Supidoc/MPT-PCB/MPT.kicad_pcb

## KiCad design MPT.kicad_pcb (2026-10-22)

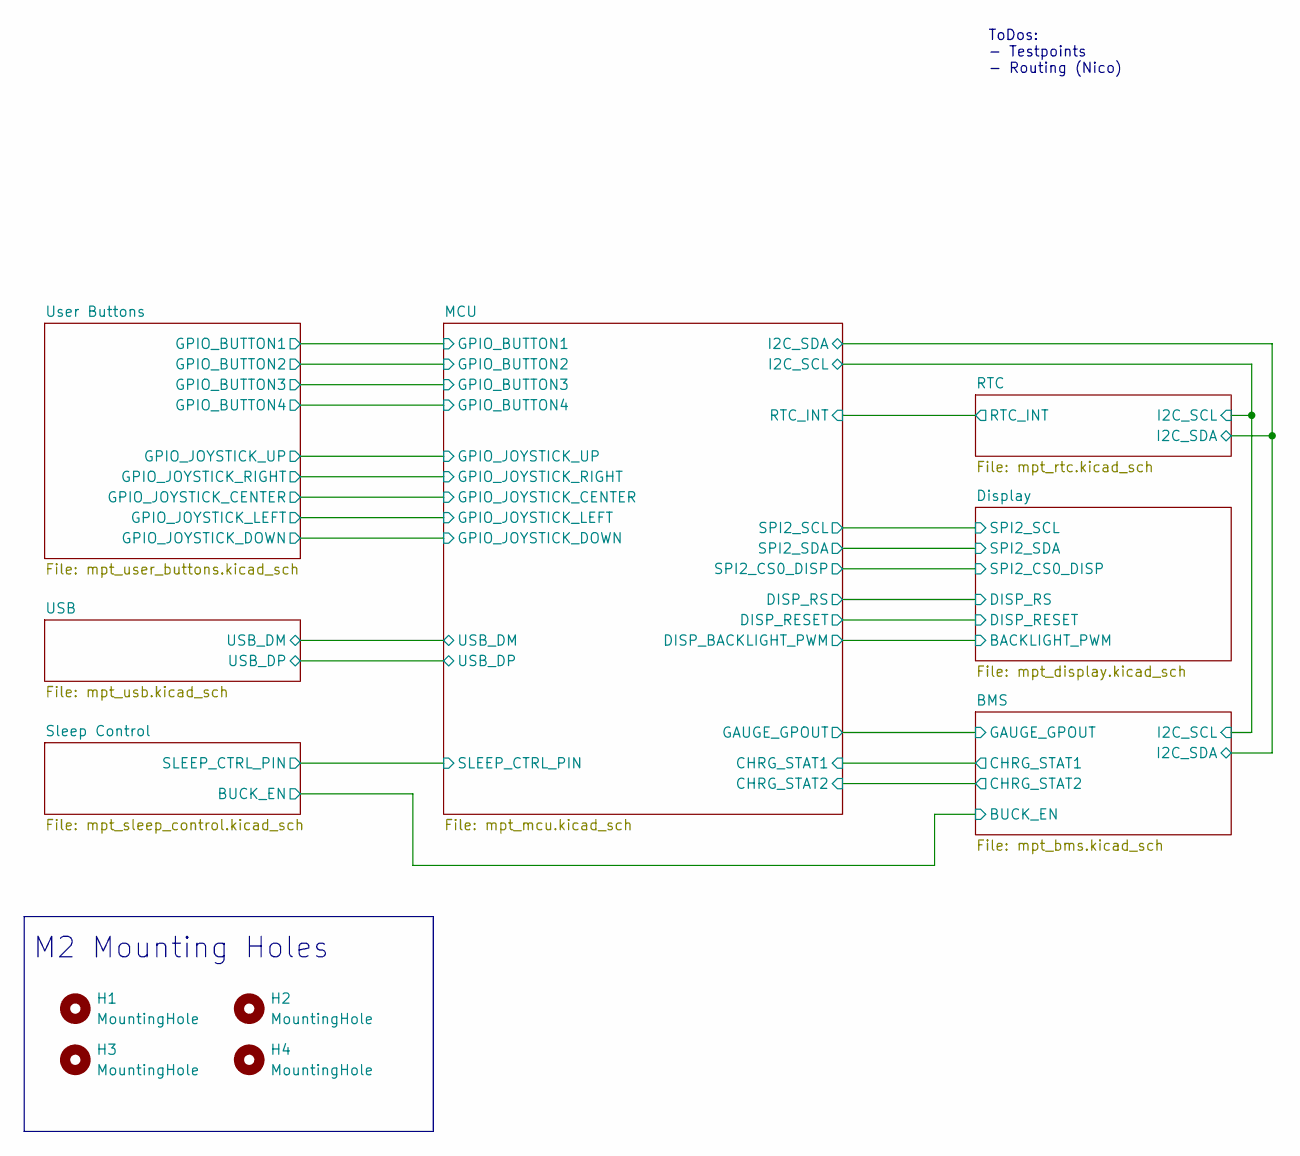
[picture p1: schematic MPT.kicad_sch, MultiPurpose Tracker (M.P.T.)]

Parts:
H1, H2, H3, H4: MountingHole; MountingHole_2.2mm_M2

Notes on the sheet:
ToDos: - Testpoints - Routing (Nico)
M2 Mounting Holes

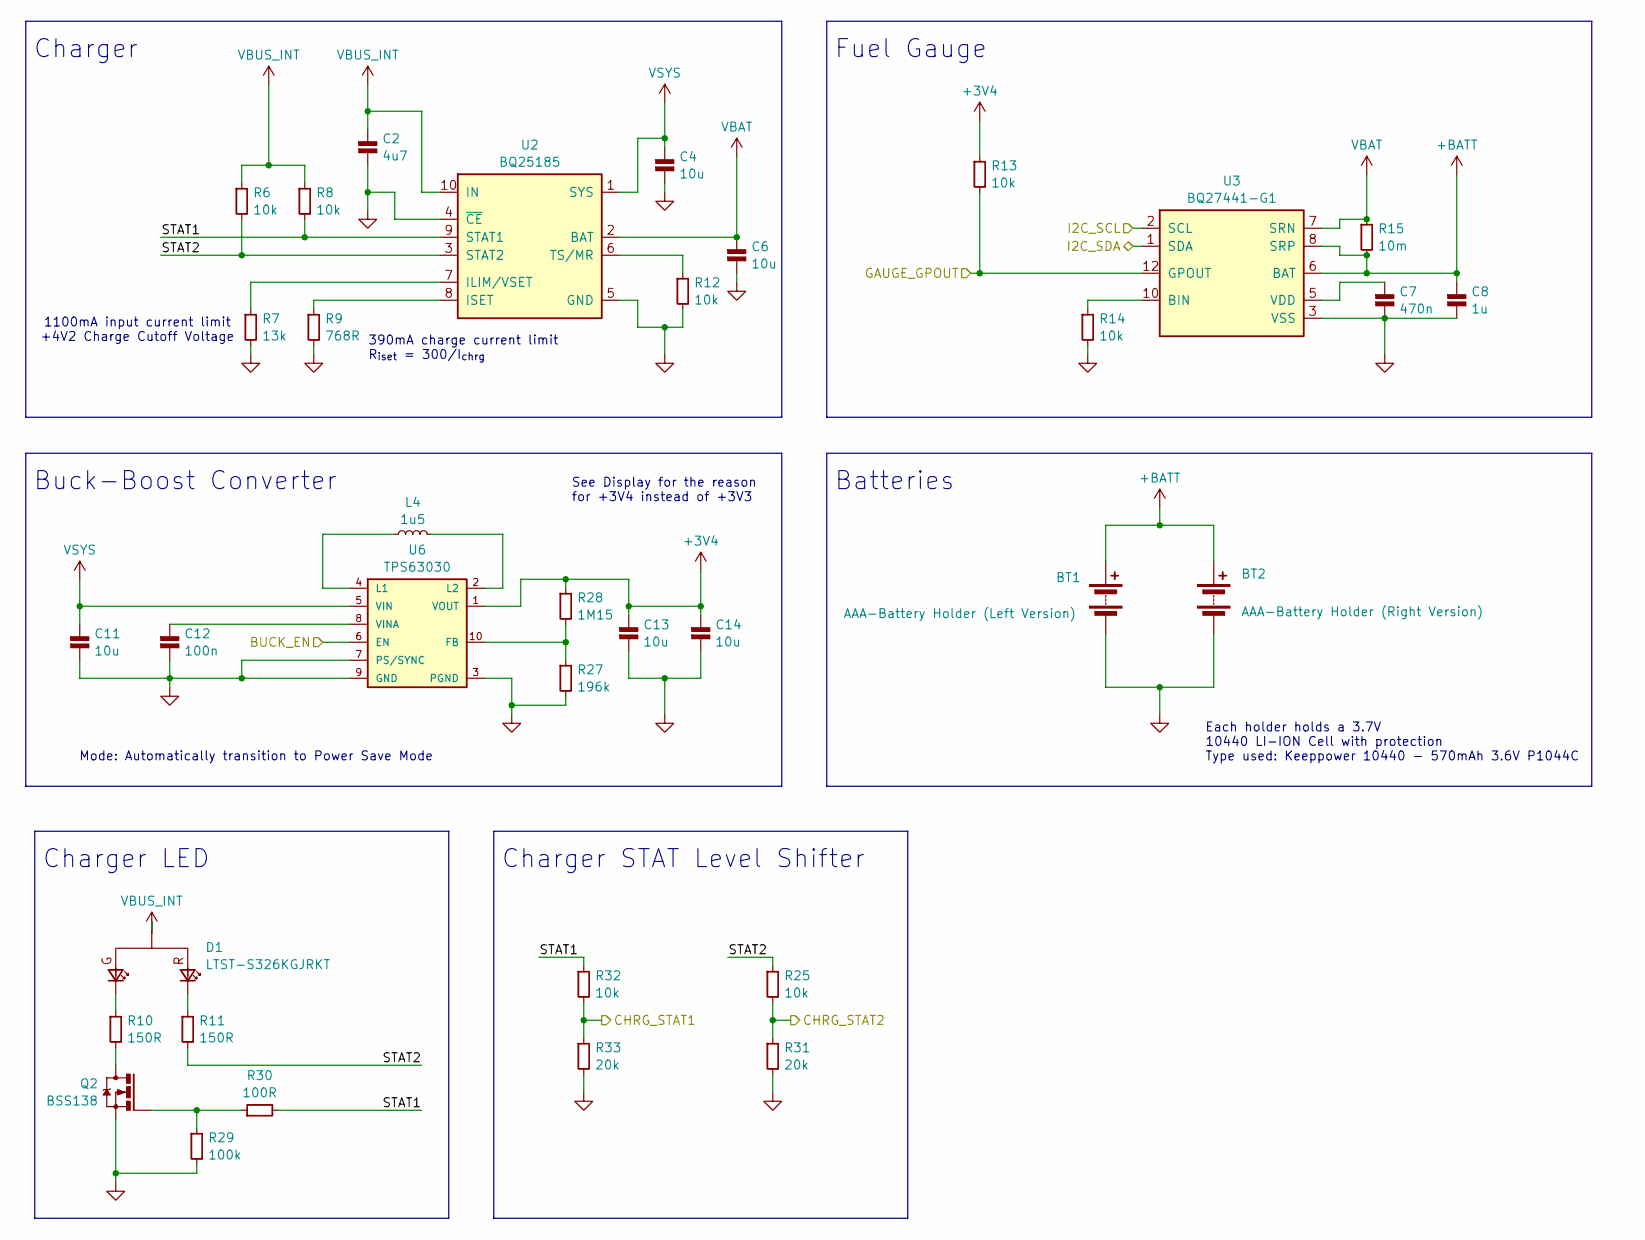
[picture p2: schematic mpt_bms.kicad_sch, M.P.T BMS]

Parts:
BT1: AAA-Battery Holder (Left Version); battery_holder_aaa_right_angle_left; MFR# 2466
BT2: AAA-Battery Holder (Right Version); battery_holder_aaa_right_angle_right; MFR# 2466
C2: 4u7; C_0805; Rating 25V 10%; MFR# CC0805KKX7R8BB475
C4, C6, C11, C13, C14: 10u; C_0603; Rating 10V 20%; MFR# CC0603MRX5R6BB106
C7: 470n; C_0603; Rating 16V 10%; MFR# CC0603KRX7R7BB474
C8: 1u; C_0603; Rating 50V 10%; MFR# CC0603KRX7R9BB105
C12: 100n; C_0603; Rating 25V 10%; MFR# CC0603KRX7R8BB104
D1: LTST-S326KGJRKT; LED_RG_0805_Right_Angle; Rating Red 2Vf, Green 2Vf; MFR# LTST-S326KGJRKT
L4: 1u5; L_2.5mmx1.9mm; Rating 2A6, 20%, 80mOhm; MFR# SRP2010TMA-1R5M
Q2: BSS138; SOT-23; Rating 50 V 220mA; MFR# BSS138
R6, R8, R12, R13, R14, R25, R32: 10k; R_0603; Rating 125mW, 1%; MFR# RC0603FR-0710KL
R7: 13k; R_0603; Rating 125mW, 1%; MFR# RC0603FR-0713KL
R9: 768R; R_0603; Rating 125mW, 1%; MFR# RC0603FR-07768RL
R10, R11: 150R; R_0603; Rating 125mW, 1%; MFR# RC0603FR-07150RL
R15: 10m; R_0603; Rating 0.5W, 1%; MFR# PA0603FRE570R01L
R27: 196k; R_0603; Rating 125mW, 1%; MFR# RC0603FR-07196KL
R28: 1M15; R_0603; Rating 125mW, 1%; MFR# RC0603FR-071M15L
R29: 100k; R_0603; Rating 125mW, 1%; MFR# RC0603FR-07100KL
R30: 100R; R_0603; Rating 125mW, 1%; MFR# RC0603FR-07100RL
R31, R33: 20k; R_0603; Rating 125mW, 1%; MFR# RC0603FR-0720KL
U2: BQ25185; WSON-10-1EP_2.2x2mm_P0.4mm; Rating 1 Cell, 1 A; MFR# BQ25185DLHR
U3: BQ27441-G1; VSON-12-1EP_2.5_4mm_P0.4mm; MFR# BQ27441DRZR-G1A
U6: TPS63030; WSON-10-1EP_2.5x2.5mm_P0.5mm; Rating 1A; MFR# TPS63030DSKR

Connections:
+3V4: C13.1, C14.1, R13.1, R28.1, U6.1 (VOUT); also elsewhere on the board
+BATT: BT1.1 (+), BT2.1 (+), C8.1, R15.2, U3.6 (BAT), U3.8 (SRP)
/BMS/BUCK_EN: U6.6 (EN); also elsewhere on the board
/BMS/CHRG_STAT1: R32.2, R33.1; also elsewhere on the board
/BMS/CHRG_STAT2: R25.2, R31.1; also elsewhere on the board
/BMS/GAUGE_GPOUT: R13.2, U3.12 (GPOUT); also elsewhere on the board
/BMS/I2C_SCL: U3.2 (SCL); also elsewhere on the board
/BMS/I2C_SDA: U3.1 (SDA); also elsewhere on the board
/BMS/STAT1: R8.2, R30.2, R32.1, U2.9 (STAT1)
/BMS/STAT2: R6.2, R11.2, R25.1, U2.3 (STAT2)
GND: BT1.2 (-), BT2.2 (-), C2.2, C4.2, C6.2, C7.2, C8.2, C11.2, C12.2, C13.2, C14.2, Q2.2 (S), R7.2, R9.2, R12.2, R14.2, R27.2, R29.2, R31.2, R33.2, U2.0 (PAD), U2.4 (~CE), U2.5 (GND), U3.0 (PAD), U3.3 (VSS), U6.0 (PAD), U6.3 (PGND), U6.7 (PS/SYNC), U6.9 (GND); also elsewhere on the board
unnamed: D1.3 (C_G), R10.1
unnamed: D1.1 (C_R), R11.1
unnamed: Q2.3 (D), R10.2
unnamed: Q2.1 (G), R29.1, R30.1
unnamed: R7.1, U2.7 (ILIM/VSET)
unnamed: R9.1, U2.8 (ISET)
unnamed: R12.1, U2.6 (TS/MR)
unnamed: R14.1, U3.10 (BIN)
unnamed: C7.1, U3.5 (VDD)
unnamed: R27.1, R28.2, U6.10 (FB)
unnamed: L4.1, U6.4 (L1)
unnamed: L4.2, U6.2 (L2)
unnamed: C12.1, U6.8 (VINA)
VBAT: C6.1, R15.1, U2.2 (BAT), U3.7 (SRN); also elsewhere on the board
VBUS_INT: C2.1, D1.2 (A), R6.1, R8.1, U2.10 (IN); also elsewhere on the board
VSYS: C4.1, C11.1, U2.1 (SYS), U6.5 (VIN); also elsewhere on the board

Notes on the sheet:
Charger
Buck-Boost Converter
390mA charge current limit R_{iset} = 300/I_{chrg}
Fuel Gauge
Batteries
Charger STAT Level Shifter
See Display for the reason for +3V4 instead of +3V3
Each holder holds a 3.7V 10440 LI-ION Cell with protection Type used: Keeppower 10440 - 570mAh 3.6V P1044C
Mode: Automatically transition to Power Save Mode
1100mA input current limit +4V2 Charge Cutoff Voltage
Charger LED

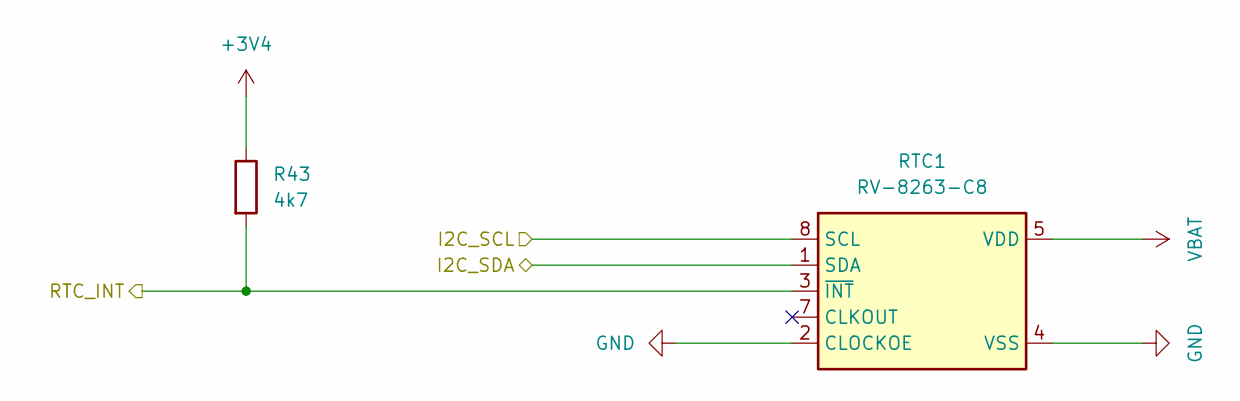
[picture p3: schematic mpt_rtc.kicad_sch, M.P.T. RTC]

Parts:
R43: 4k7; R_0603_1608Metric
RTC1: RV-8263-C8; IC_RV-8263-C8-32.768KHZ-20PPM-TA-QC

Connections:
+3V4: R43.1; also elsewhere on the board
/BMS/I2C_SCL: RTC1.8 (SCL); also elsewhere on the board
/BMS/I2C_SDA: RTC1.1 (SDA); also elsewhere on the board
/MCU/RTC_INT: R43.2, RTC1.3 (~INT); also elsewhere on the board
GND: RTC1.2 (CLOCKOE), RTC1.4 (VSS); also elsewhere on the board
VBAT: RTC1.5 (VDD); also elsewhere on the board

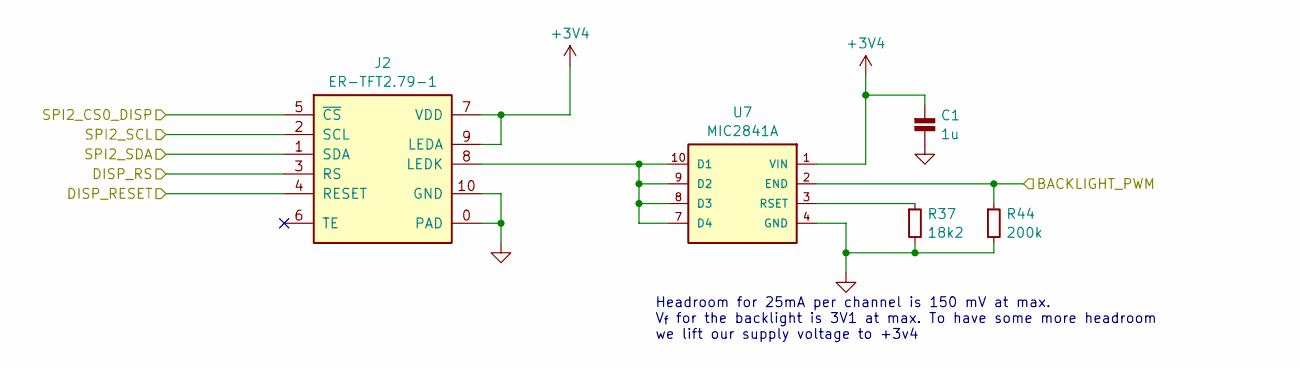
[picture p4: schematic mpt_display.kicad_sch, M.P.T Display]

Parts:
C1: 1u; C_0603; Rating 50V 10%; MFR# CC0603KRX7R9BB105
J2: ER-TFT2.79-1; Rating 2.79" IPS TFT LCD; MFR# ER-TFT2.79-1
R37: 18k2; R_0603; Rating 125mW, 1%; MFR# RC0603FR-0718K2L
R44: 200k; R_0603; Rating 125mW, 1%; MFR# RC0603FR-07200KL
U7: MIC2841A; MLF-10_MT_MCH; Rating 20mA 4 Ch; MFR# MIC2841AYMT-TR

Connections:
+3V4: C1.1, J2.7 (VDD), J2.9 (LEDA), U7.1 (VIN); also elsewhere on the board
/Display/BACKLIGHT_PWM: R44.1, U7.2 (END); also elsewhere on the board
/Display/DISP_RESET: J2.4 (RESET); also elsewhere on the board
/Display/DISP_RS: J2.3 (RS); also elsewhere on the board
/Display/SPI2_CS0_DISP: J2.5 (~CS); also elsewhere on the board
/Display/SPI2_SCL: J2.2 (SCL); also elsewhere on the board
/Display/SPI2_SDA: J2.1 (SDA); also elsewhere on the board
GND: C1.2, J2.0 (PAD), J2.10 (GND), R37.2, R44.2, U7.0 (PAD), U7.4 (GND); also elsewhere on the board
unnamed: J2.8 (LEDK), U7.7 (D4), U7.8 (D3), U7.9 (D2), U7.10 (D1)
unnamed: R37.1, U7.3 (RSET)

Notes on the sheet:
Headroom for 25mA per channel is 150 mV at max. V_{f} for the backlight is 3V1 at max. To have some more headroom we lift our supply voltage to +3v4

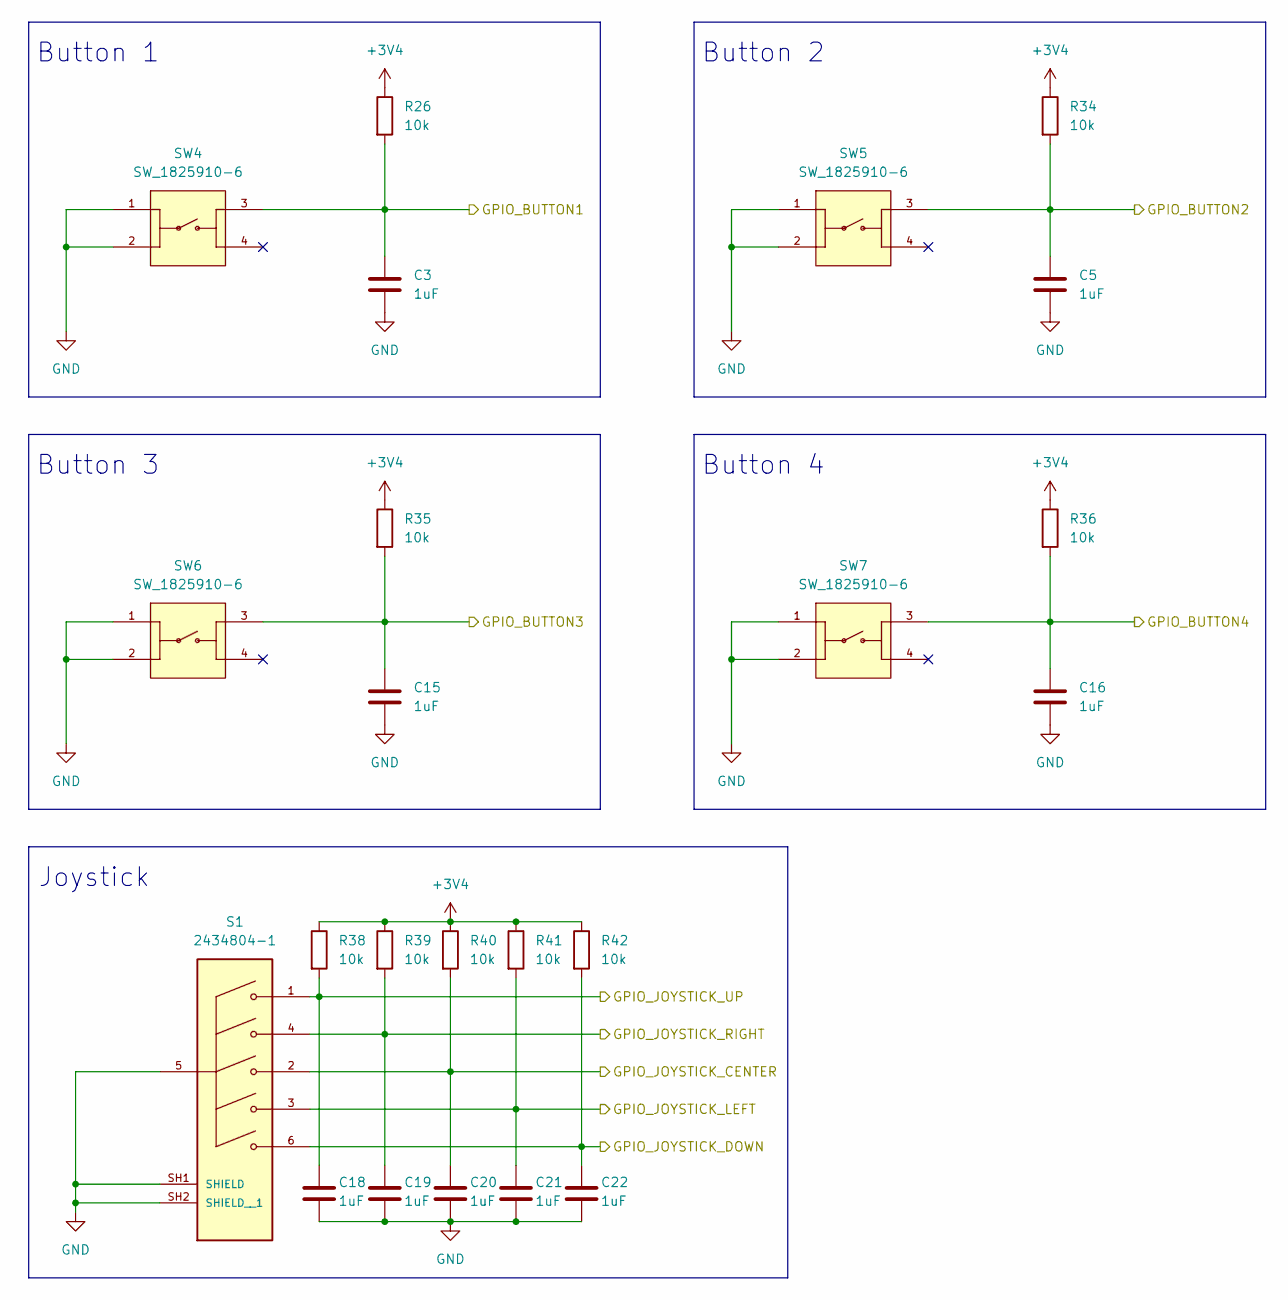
[picture p5: schematic mpt_user_buttons.kicad_sch, M.P.T User Buttons]

Parts:
C3, C5, C15, C16, C18, C19, C20, C21, C22: 1uF; C_0603_1608Metric
R26, R34, R35, R36, R38, R39, R40, R41, R42: 10k; R_0603_1608Metric
S1: 2434804-1; SW_2434804-1; PARTREV A
SW4, SW5, SW6, SW7: SW_1825910-6; SW_1825910-6-4; PARTREV C10

Connections:
+3V4: R26.1, R34.1, R35.1, R36.1, R38.1, R39.1, R40.1, R41.1, R42.1; also elsewhere on the board
/MCU/GPIO_BUTTON1: C3.1, R26.2, SW4.3; also elsewhere on the board
/MCU/GPIO_BUTTON2: C5.1, R34.2, SW5.3; also elsewhere on the board
/MCU/GPIO_BUTTON3: C15.1, R35.2, SW6.3; also elsewhere on the board
/MCU/GPIO_BUTTON4: C16.1, R36.2, SW7.3; also elsewhere on the board
/MCU/GPIO_JOYSTICK_CENTER: C20.1, R40.2, S1.2; also elsewhere on the board
/MCU/GPIO_JOYSTICK_DOWN: C22.1, R42.2, S1.6; also elsewhere on the board
/MCU/GPIO_JOYSTICK_LEFT: C21.1, R41.2, S1.3; also elsewhere on the board
/MCU/GPIO_JOYSTICK_RIGHT: C19.1, R39.2, S1.4; also elsewhere on the board
/MCU/GPIO_JOYSTICK_UP: C18.1, R38.2, S1.1; also elsewhere on the board
GND: C3.2, C5.2, C15.2, C16.2, C18.2, C19.2, C20.2, C21.2, C22.2, S1.5, S1.SH1 (SHIELD), S1.SH2 (SHIELD__1), SW4.1, SW4.2, SW5.1, SW5.2, SW6.1, SW6.2, SW7.1, SW7.2; also elsewhere on the board

Notes on the sheet:
Button 2
Button 4
Joystick
Button 1
Button 3

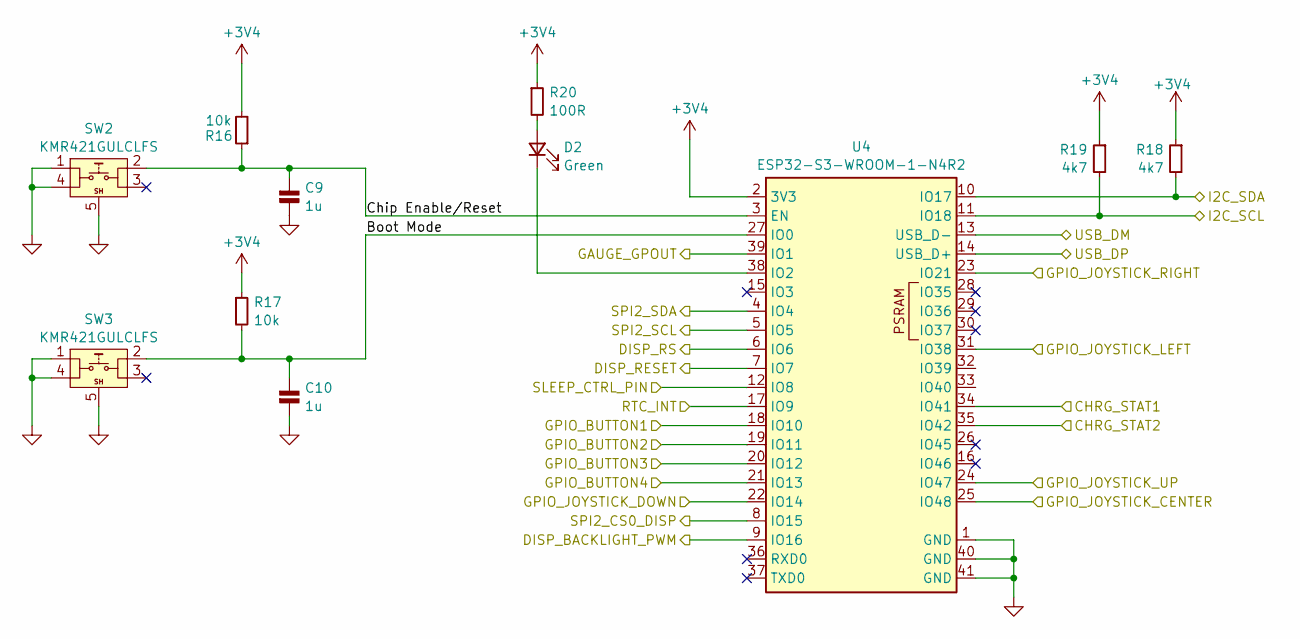
[picture p6: schematic mpt_mcu.kicad_sch, M.P.T MCU]

Parts:
C9, C10: 1u; C_0603; Rating 50V 10%; MFR# CC0603KRX7R9BB105
D2: Green; D_0603; Rating 2v1 20mA 569nm; MFR# LTST-C190GKT
R16, R17: 10k; R_0603; Rating 125mW, 1%; MFR# RC0603FR-0710KL
R18, R19: 4k7; R_0603; Rating 100mW, 1%; MFR# RC0603FR-074K7L
R20: 100R; R_0603; Rating 125mW, 1%; MFR# RC0603FR-07100RL
SW2, SW3: KMR421GULCLFS; Rating 1VA; MFR# KMR421GULCLFS
U4: ESP32-S3-WROOM-1-N4R2; ESP32_S3_WROOM_1; Rating 4 MB Flash, 2 MB PSRAM; MFR# ESP32-S3-WROOM-1-N4R2

Connections:
+3V4: R16.2, R17.1, R18.1, R19.1, R20.1, U4.2 (3V3); also elsewhere on the board
/BMS/CHRG_STAT1: U4.34 (IO41); also elsewhere on the board
/BMS/CHRG_STAT2: U4.35 (IO42); also elsewhere on the board
/BMS/GAUGE_GPOUT: U4.39 (IO1); also elsewhere on the board
/BMS/I2C_SCL: R19.2, U4.11 (IO18); also elsewhere on the board
/BMS/I2C_SDA: R18.2, U4.10 (IO17); also elsewhere on the board
/Display/BACKLIGHT_PWM: U4.9 (IO16); also elsewhere on the board
/Display/DISP_RESET: U4.7 (IO7); also elsewhere on the board
/Display/DISP_RS: U4.6 (IO6); also elsewhere on the board
/Display/SPI2_CS0_DISP: U4.8 (IO15); also elsewhere on the board
/Display/SPI2_SCL: U4.5 (IO5); also elsewhere on the board
/Display/SPI2_SDA: U4.4 (IO4); also elsewhere on the board
/MCU/Boot Mode: C10.1, R17.2, SW3.2, U4.27 (IO0)
/MCU/Chip Enable/Reset: C9.1, R16.1, SW2.2, U4.3 (EN)
/MCU/GPIO_BUTTON1: U4.18 (IO10); also elsewhere on the board
/MCU/GPIO_BUTTON2: U4.19 (IO11); also elsewhere on the board
/MCU/GPIO_BUTTON3: U4.20 (IO12); also elsewhere on the board
/MCU/GPIO_BUTTON4: U4.21 (IO13); also elsewhere on the board
/MCU/GPIO_JOYSTICK_CENTER: U4.25 (IO48); also elsewhere on the board
/MCU/GPIO_JOYSTICK_DOWN: U4.22 (IO14); also elsewhere on the board
/MCU/GPIO_JOYSTICK_LEFT: U4.31 (IO38); also elsewhere on the board
/MCU/GPIO_JOYSTICK_RIGHT: U4.23 (IO21); also elsewhere on the board
/MCU/GPIO_JOYSTICK_UP: U4.24 (IO47); also elsewhere on the board
/MCU/RTC_INT: U4.17 (IO9); also elsewhere on the board
/MCU/SLEEP_CTRL_PIN: U4.12 (IO8); also elsewhere on the board
/MCU/USB_DM: U4.13 (USB_D-); also elsewhere on the board
/MCU/USB_DP: U4.14 (USB_D+); also elsewhere on the board
GND: C9.2, C10.2, SW2.1, SW2.4 (3), SW2.5 (SH), SW3.1, SW3.4 (3), SW3.5 (SH), U4.1 (GND), U4.40 (GND), U4.41 (GND); also elsewhere on the board
unnamed: D2.1 (A), R20.2
unnamed: D2.2 (K), U4.38 (IO2)

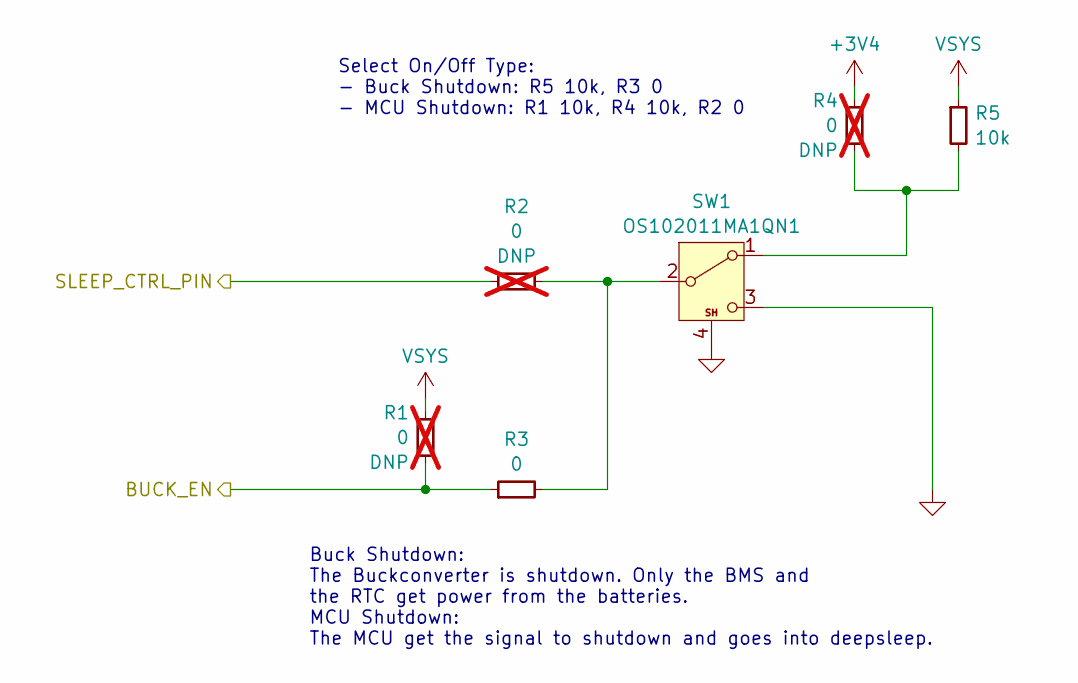
[picture p7: schematic mpt_sleep_control.kicad_sch, M.P.T. Sleep Control]

Parts:
R1, R2, R4: 0; R_0603_DNP; not fitted
R3: 0; R_0603; Rating 100mW; MFR# RC0603JR-070RL
R5: 10k; R_0603; Rating 125mW, 1%; MFR# RC0603FR-0710KL
SW1: OS102011MA1QN1; OS102011MA1QN1_CNK; Rating 100MA 12V Non-shorting; MFR# OS102011MA1QN1

Connections:
+3V4: R4.1; also elsewhere on the board
/BMS/BUCK_EN: R1.2, R3.1; also elsewhere on the board
/MCU/SLEEP_CTRL_PIN: R2.1; also elsewhere on the board
GND: SW1.3 (C), SW1.4 (SH); also elsewhere on the board
unnamed: R4.2, R5.2, SW1.1 (A)
unnamed: R2.2, R3.2, SW1.2 (B)
VSYS: R1.1, R5.1; also elsewhere on the board

Notes on the sheet:
Buck Shutdown: The Buckconverter is shutdown. Only the BMS and the RTC get power from the batteries. MCU Shutdown: The MCU get the signal to shutdown and goes into deepsleep.
Select On/Off Type: - Buck Shutdown: R5 10k, R3 0 - MCU Shutdown: R1 10k, R4 10k, R2 0

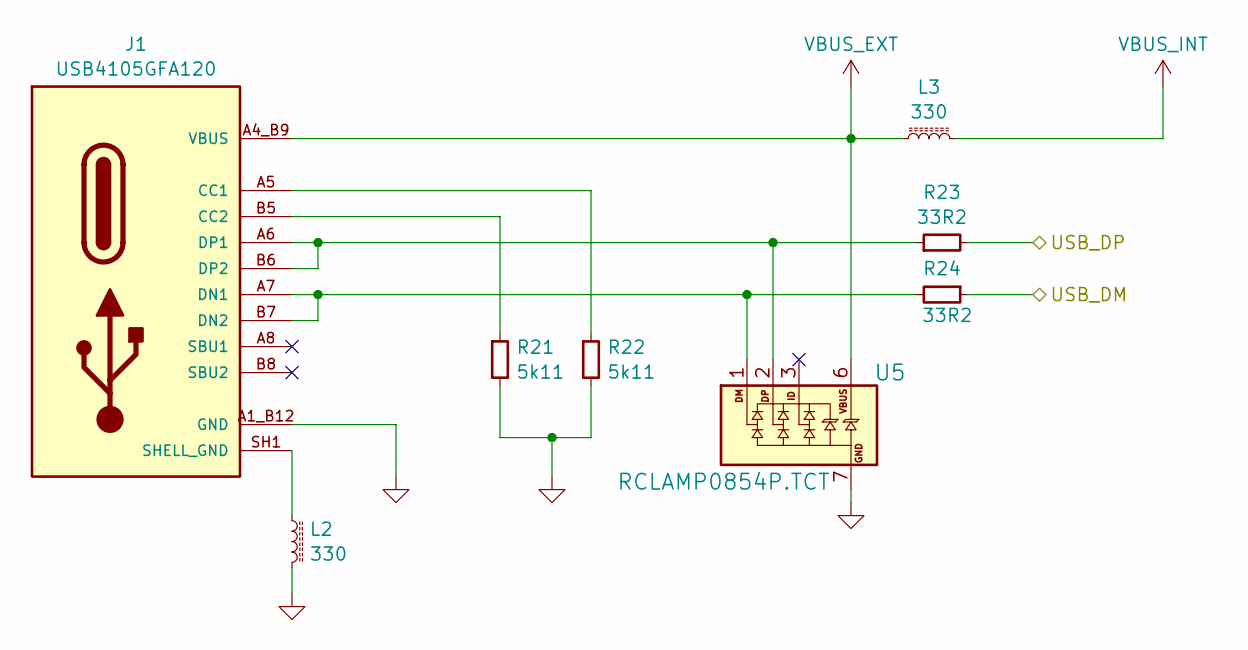
[picture p8: schematic mpt_usb.kicad_sch, M.P.T USB]

Parts:
J1: USB4105GFA120; GCT_USB4105GFA120; Rating 16 Pin; MFR# USB4105-GF-A-120
L2, L3: 330; L_0603; Rating 330 Ohms @ 100 MHz 1.7A 80mOhm; MFR# MPZ1608S331ATA00
R21, R22: 5k11; R_0603; Rating 125mW, 1%; MFR# RC0603FR-075K11L
R23, R24: 33R2; R_0603; Rating 125mW, 1%; MFR# RC0603FR-0733R2L
U5: RCLAMP0854P.TCT; UFDFN06_1P6X1P6; Rating 5.5VWM 30VC; MFR# RCLAMP0854P.TCT

Connections:
/MCU/USB_DM: R24.1; also elsewhere on the board
/MCU/USB_DP: R23.2; also elsewhere on the board
GND: J1.A1_B12 (GND), J1.B1_A12 (GND), L2.2, R21.2, R22.2, U5.7 (GND); also elsewhere on the board
unnamed: J1.A5 (CC1), R22.1
unnamed: J1.B5 (CC2), R21.1
unnamed: J1.A7 (DN1), J1.B7 (DN2), R24.2, U5.1 (DM)
unnamed: J1.A6 (DP1), J1.B6 (DP2), R23.1, U5.2 (DP)
SHELL_GND: J1.SH1 (SHELL_GND), J1.SH2 (SHELL_GND), J1.SH3 (SHELL_GND), J1.SH4 (SHELL_GND), L2.1
VBUS_EXT: J1.A4_B9 (VBUS), J1.B4_A9 (VBUS), L3.1, U5.6 (VBUS)
VBUS_INT: L3.2; also elsewhere on the board

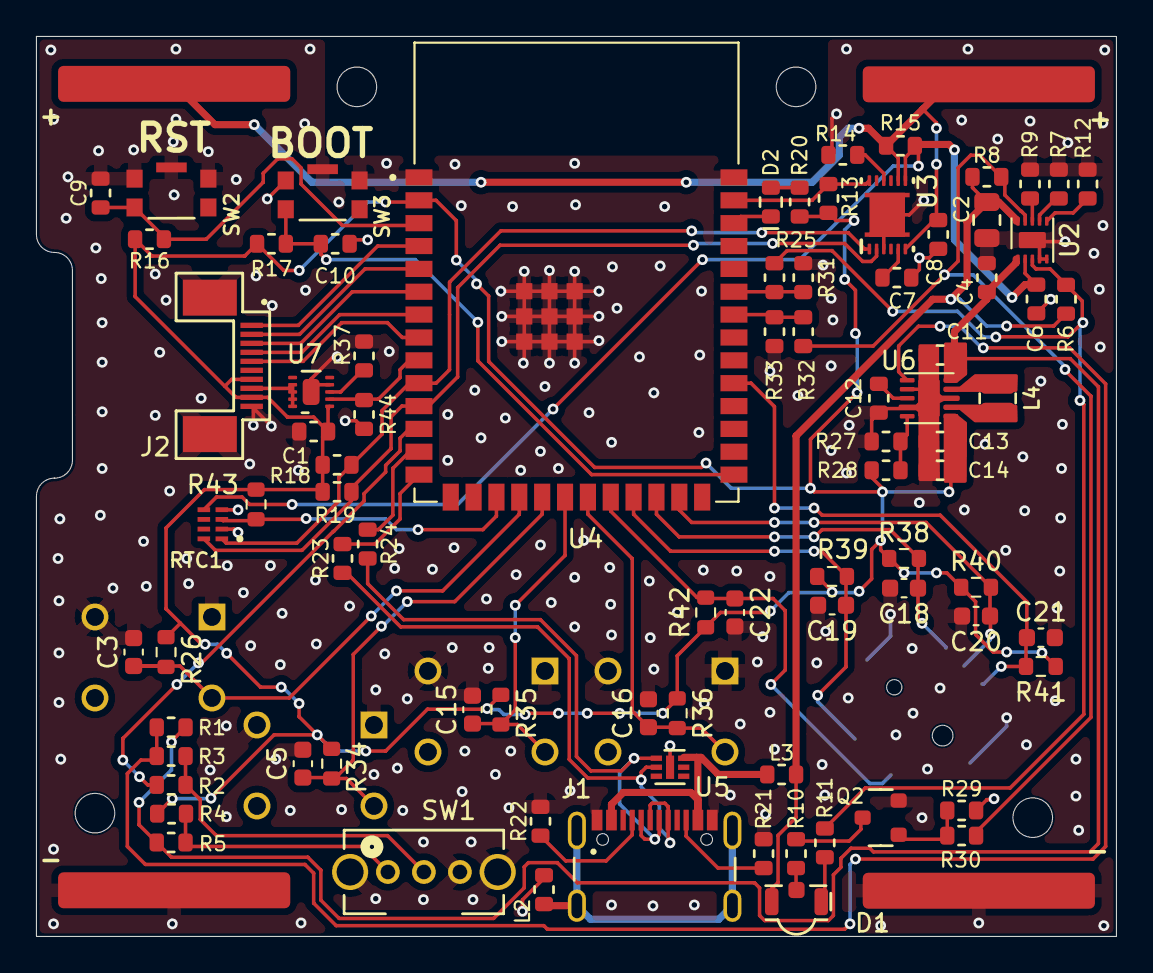
[picture p9: board MPT.kicad_pcb from above]

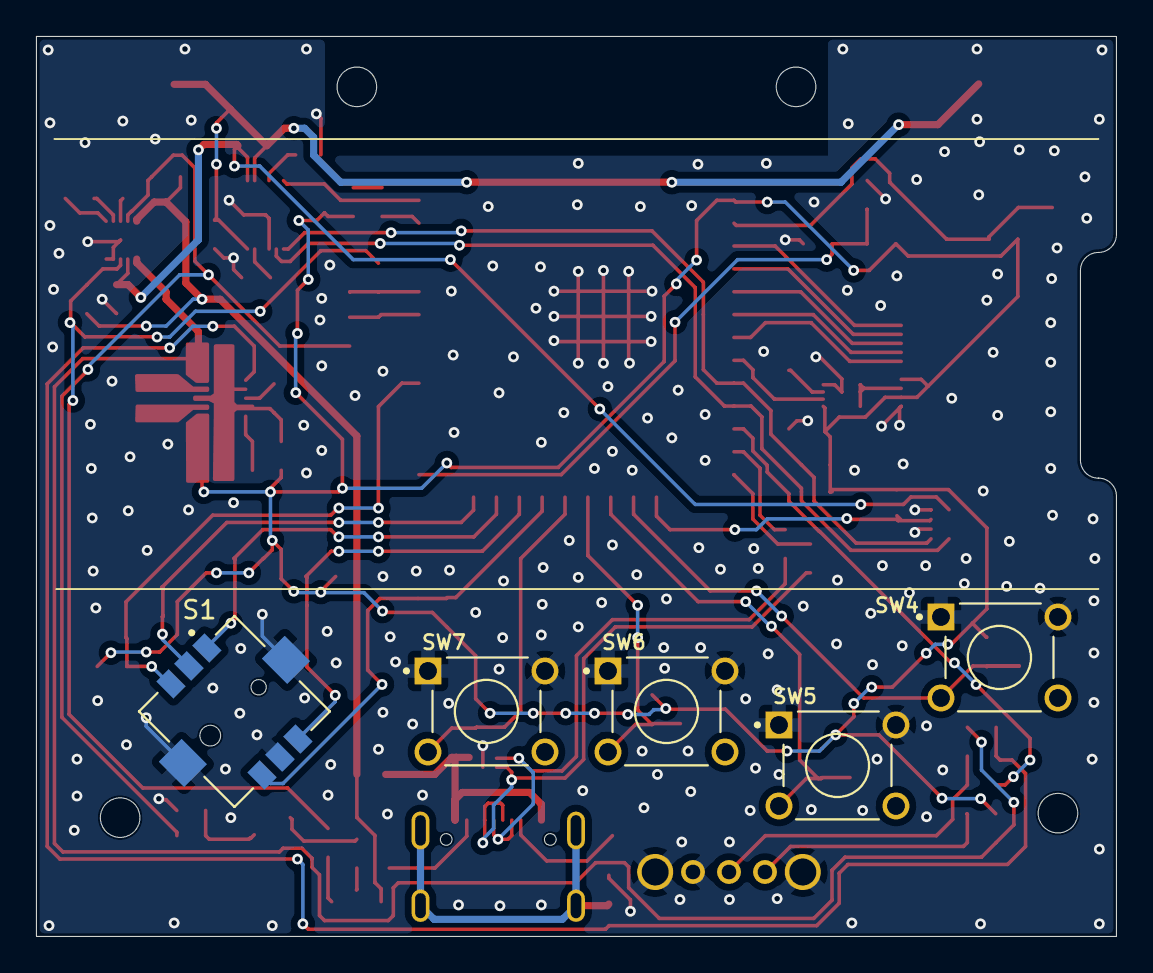
[picture p10: board MPT.kicad_pcb from below]

Board: 2 copper layers, 60.0 x 50.0 mm, 94 parts (5 on the bottom side), 60 nets.
