Supidoc/MPT-PCB/(commit log)

2026-10-10 Added Info-Table for STAT Pins and LEDS of Charger Work In Progress regulation for Display driving (currently not working)
    [MPT.kicad_sch, mpt_bms.kicad_sch, mpt_display.kicad_sch, mpt_mcu.kicad_sch]
2026-10-12 Changed LED Driver for one with lower Headroom
2026-10-12 RTC Finished, changes to User Buttons
2026-10-12 Footprints and Symbols for SW, RTC and Joystick
2026-10-12 User Buttons Finished
2026-10-13 Updated PCB Layout with new Buck Boost, Display driver and STAT Led logic
2026-10-15 RTC and User Buttons small changes
2026-10-18 Make Block Titles consistent in size Remove not connected marks on mcu for pins which can be used for user buttons and other stuff Add User button hierarchy lables for Button 4 & 5 on MCU sheet Fix h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
2026-10-19 Footprints added, Userbuttons and RTC added on PCB Layout
2026-10-20 Mountingholes Added
2026-10-20 Replace LED Driver Remove maybe buzzer
2026-10-21 PCB Layout Connecting
2026-10-22 Added GND Network and connected all components
